yogeswara-reddy/iddq-cpu-fsm-testing/RWU_RV/RV_NoPipeline/spec/RWU_RV64I_Cache_Analysis.xlsx

Sheet: Legende
RWU-RV64I — Cache-Speichersystem (Hennessy-Patterson Analyse)
Prozess: X-Fab XO035 (350 nm) | Architektur: Harvard | Konfiguration: I-Cache + D-Cache (je 4-way SA, 4 KB), Scratchpad SRAM
Eigenschaft | I-Cache | D-Cache (Flash-Region) | D-Cache (Scratchpad-Region) | Scratchpad SRAM (Bypass)
Kapazität | 4 KB (param.) | 4 KB (param.) | n/a (bypass) | TBD (param.)
Assoziativität | 4-fach set-assoziativ | 4-fach set-assoziativ | — | direkt adressiert
Sets / Cacheline | 32 Sets, 32 B | 32 Sets, 32 B | — | —
Ersetzungsstrategie | Pseudo-LRU (3 Bit/Set) | Pseudo-LRU (3 Bit/Set) | — | —
Write Policy | read-only (kein Write) | read-allocate, no-write-back | kein Cache (bypass) | write-through direkt
Write-Allocate | nicht anwendbar | nein (Flash read-only) | nein (bypass) | nicht anwendbar
Dirty Bit | nein | nein (eliminiert) | nein | —
Hit-Latenz | 1 Systemtakt | 1 Systemtakt | 1–2 Systemtakte (bypass) | 1–2 Systemtakte
Miss-Penalty | 106 × f_sys/f_QSPI Takte | 106 × f_sys/f_QSPI Takte | — (kein Miss möglich) | —
AXI4 Write-Path | nein | nein (eliminiert) | nein | nein
AXI4 Read-Path | ja (AR + R Kanal) | ja (AR + R Kanal) | nein | nein
Bus zum Speicher | AXI4 Burst (ARLEN=3) | AXI4 Burst (ARLEN=3) | SRAM-Interface (sync.) | SRAM-Interface (sync.)
H&P Begriff |  | Bedeutung / Formel |  | In diesem System
Hit Time (t_hit) |  | Zugriffszeit bei Cache-Treffer |  | 1 Systemtakt (I+D)
Miss Rate (m) |  | Anteil Zugriffe ohne Treffer |  | I-Cache: abhängig vom Code-Footprint D-Cache (Flash): abhängig von .rodata-Zugriffen
Miss Penalty (t_miss) |  | Mehrzyklen bei Miss bis Daten bereit stehen |  | 106 × (f_sys / f_QSPI_SCK) Takte ≡ 4.24 µs bei 25 MHz QSPI (beide Flash-Typen)
AMAT |  | Average Memory Access Time = t_hit + m × t_miss |  | I: 1 + m_I × t_miss D: 1 + m_D × t_miss (nur Load-Misses aus Flash)
Memory Stall CPI |  | Taktzyklen/Instr. für Speicherwartezustände = m_I×t_miss + load_freq×m_D×t_miss |  | Store-Misses = 0 (Scratchpad-Bypass, kein Flash-Write)
CPI_eff |  | Effektiver CPI = CPI_ideal + Memory_Stall_CPI |  | CPI_ideal = 1 (No-Pipeline-CPU)
Write-Through |  | Jeder Write sofort in Backing Store |  | NICHT verwendet (kein Flash-Write)
Write-Back |  | Write erst bei Eviction in Backing Store |  | NICHT verwendet (Flash read-only, Dirty-Bit eliminiert)
Write-Allocate |  | Miss bei Write → Cache-Line laden |  | NICHT verwendet (Stores gehen direkt → Scratchpad)
No-Write-Allocate |  | Miss bei Write → direkt in Backing Store |  | NICHT relevant (Scratchpad ist nicht Flash)
Read-Allocate |  | Miss bei Load → neue Line in Cache laden |  | JA – für I-Cache und D-Cache (Flash-Region)
Pseudo-LRU (PLRU) |  | 3-Bit-Approximation des LRU für 4-Wege |  | 1 PLRU-Feld pro Set (96 Bit Tag-SRAM enthält 3 PLRU-Bits)
Scratchpad |  | Direkt adressierter SRAM (kein Cache) |  | Hält Stack, Heap, .data, .bss D-Cache-Controller bypassed direkt
Linker-Segment | Read/Write | Inhalt |  | Speicherort
.text | RO | Programmcode (Instruktionen) |  | NOR Flash → I-Cache
.rodata | RO | Konstanten, String-Literale |  | NOR Flash → D-Cache (Flash-Region)
.data | RW | Initialisierte globale/statische Variablen |  | Scratchpad (Kopie von Flash bei Boot)
.bss | RW | Uninitial. glob./stat. Var. (Null-Init.) |  | Scratchpad (Start-up nullt Region)
Heap | RW | Dynamisch alloz. Speicher (malloc/free) |  | Scratchpad (wächst ↑ von .bss)
Stack | RW | Auto-Variablen, Rücksprungadr., Register-Save |  | Scratchpad (wächst ↓ von oben)

Sheet: AMAT_Szenarien
AMAT-Analyse nach Hennessy-Patterson — RWU-RV64I Cache-System
System-Parameter
t_hit (I-Cache + D-Cache) |  | 1 | Systemtakt | Kombinatorisch: Tag-Vergleich + SRAM-Read in 1 Takt
t_hit (Scratchpad Bypass) |  | 1–2 | Systemtakte | D-Cache-Controller → SRAM direkt
QSPI-Protokoll-Zyklen (tot.) |  | 106 | QSPI-SCK-Takte | 8 (Opcode)+24 (Adr)+8 (Dummy)+64 (Daten, Quad)+2 (CS#)
Miss-Penalty t_miss |  | 106 × (f_sys / f_QSPI) | Systemtakte | Skalar von Taktverhältnis, siehe Takt-Matrix
Beispiel: f_sys=25 MHz, f_QSPI=25 MHz |  | 106 | Systemtakte | ≡ 4.24 µs
Beispiel: f_sys=10 MHz, f_QSPI=25 MHz |  | 42 | Systemtakte | ≡ 4.24 µs (Spec-Referenzpunkt)
CPI_ideal (No-Pipeline) |  | 1 | Takte/Instr. | Ein Fetch pro Takt (ohne Speicherstalls)
Instruction Mix (typisch) |  | — | — | 25 % Load, 10 % Store, 20 % Branch, 45 % ALU
Store-Miss-Penalty |  | 0 | — | Stores → Scratchpad Bypass (kein Flash-Write)
Hennessy-Patterson Formeln (angewendet auf RWU-RV64I)
AMAT = t_hit + m × t_miss
CPI_eff = CPI_ideal + I$_stall + D$_stall
I$_stall = m_I × t_miss [Takte pro Instruktion]
D$_stall = load_freq × m_D × t_miss [Store-Miss = 0, Scratchpad-Bypass!]
Memory_Stall_CPI = m_I × t_miss + 0.25 × m_D × t_miss
Szenario: f_sys=10 MHz, f_QSPI=25 MHz (Spec-Referenz) | t_miss = 42 Systemtakte
Miss-Rate m | AMAT_I [Takte] | AMAT_D [Takte] | I$_stall/Instr | D$_stall/Instr | Mem_Stall_CPI | CPI_eff | IPC_eff | Speed-Up vs. ideal | Zeitverlust [%] | CPI-Diagramm (normiert) | Klassifikation
0.1 % | 1.04 | 1.04 | 0.04 | 0.01 | 0.05 | 1.05 | 0.950 | 1.05 | 5.2 | █ | sehr gut
0.5 % | 1.21 | 1.21 | 0.21 | 0.05 | 0.26 | 1.26 | 0.792 | 1.26 | 26.2 | █ | sehr gut
1.0 % | 1.42 | 1.42 | 0.42 | 0.10 | 0.53 | 1.52 | 0.656 | 1.52 | 52.5 | █ | sehr gut
2.0 % | 1.84 | 1.84 | 0.84 | 0.21 | 1.05 | 2.05 | 0.488 | 2.05 | 105.0 | █ | gut
5.0 % | 3.10 | 3.10 | 2.10 | 0.53 | 2.62 | 3.62 | 0.276 | 3.62 | 262.5 | ██ | gut
10.0 % | 5.20 | 5.20 | 4.20 | 1.05 | 5.25 | 6.25 | 0.160 | 6.25 | 525.0 | █████ | akzeptabel
15.0 % | 7.30 | 7.30 | 6.30 | 1.57 | 7.88 | 8.88 | 0.113 | 8.88 | 787.5 | ███████ | problematisch
20.0 % | 9.40 | 9.40 | 8.40 | 2.10 | 10.50 | 11.50 | 0.087 | 11.50 | 1050.0 | ██████████ | problematisch
30.0 % | 13.60 | 13.60 | 12.60 | 3.15 | 15.75 | 16.75 | 0.060 | 16.75 | 1575.0 | ███████████████ | kritisch
50.0 % | 22.00 | 22.00 | 21.00 | 5.25 | 26.25 | 27.25 | 0.037 | 27.25 | 2625.0 | ████████████████████+ | kritisch
Grün ≤ 1 % | Hell-Grün ≤ 5 % | Gelb ≤ 10 % | Orange ≤ 20 % | Rot > 20 %
Szenario: f_sys=25 MHz, f_QSPI=25 MHz (Empfehlung: kein PLL) | t_miss = 106 Systemtakte
Miss-Rate m | AMAT_I [Takte] | AMAT_D [Takte] | I$_stall/Instr | D$_stall/Instr | Mem_Stall_CPI | CPI_eff | IPC_eff | Speed-Up vs. ideal | Zeitverlust [%] | CPI-Diagramm (normiert) | Klassifikation
0.1 % | 1.11 | 1.11 | 0.11 | 0.03 | 0.13 | 1.13 | 0.883 | 1.13 | 13.3 | █ | sehr gut
0.5 % | 1.53 | 1.53 | 0.53 | 0.13 | 0.66 | 1.66 | 0.602 | 1.66 | 66.3 | █ | sehr gut
1.0 % | 2.06 | 2.06 | 1.06 | 0.27 | 1.32 | 2.33 | 0.430 | 2.33 | 132.5 | █ | sehr gut
2.0 % | 3.12 | 3.12 | 2.12 | 0.53 | 2.65 | 3.65 | 0.274 | 3.65 | 265.0 | ██ | gut
5.0 % | 6.30 | 6.30 | 5.30 | 1.32 | 6.63 | 7.63 | 0.131 | 7.63 | 662.5 | ██████ | gut
10.0 % | 11.60 | 11.60 | 10.60 | 2.65 | 13.25 | 14.25 | 0.070 | 14.25 | 1325.0 | █████████████ | akzeptabel
15.0 % | 16.90 | 16.90 | 15.90 | 3.98 | 19.88 | 20.88 | 0.048 | 20.88 | 1987.5 | ███████████████████ | problematisch
20.0 % | 22.20 | 22.20 | 21.20 | 5.30 | 26.50 | 27.50 | 0.036 | 27.50 | 2650.0 | ████████████████████+ | problematisch
30.0 % | 32.80 | 32.80 | 31.80 | 7.95 | 39.75 | 40.75 | 0.025 | 40.75 | 3975.0 | ████████████████████+ | kritisch
50.0 % | 54.00 | 54.00 | 53.00 | 13.25 | 66.25 | 67.25 | 0.015 | 67.25 | 6625.0 | ████████████████████+ | kritisch
Grün ≤ 1 % | Hell-Grün ≤ 5 % | Gelb ≤ 10 % | Orange ≤ 20 % | Rot > 20 %
Szenario: f_sys=50 MHz, f_QSPI=25 MHz (Empfehlung: PLL×2) | t_miss = 212 Systemtakte
Miss-Rate m | AMAT_I [Takte] | AMAT_D [Takte] | I$_stall/Instr | D$_stall/Instr | Mem_Stall_CPI | CPI_eff | IPC_eff | Speed-Up vs. ideal | Zeitverlust [%] | CPI-Diagramm (normiert) | Klassifikation
0.1 % | 1.21 | 1.21 | 0.21 | 0.05 | 0.27 | 1.26 | 0.791 | 1.26 | 26.5 | █ | sehr gut
0.5 % | 2.06 | 2.06 | 1.06 | 0.27 | 1.32 | 2.33 | 0.430 | 2.33 | 132.5 | █ | sehr gut
1.0 % | 3.12 | 3.12 | 2.12 | 0.53 | 2.65 | 3.65 | 0.274 | 3.65 | 265.0 | ██ | sehr gut
2.0 % | 5.24 | 5.24 | 4.24 | 1.06 | 5.30 | 6.30 | 0.159 | 6.30 | 530.0 | █████ | gut
5.0 % | 11.60 | 11.60 | 10.60 | 2.65 | 13.25 | 14.25 | 0.070 | 14.25 | 1325.0 | █████████████ | gut
10.0 % | 22.20 | 22.20 | 21.20 | 5.30 | 26.50 | 27.50 | 0.036 | 27.50 | 2650.0 | ████████████████████+ | akzeptabel
15.0 % | 32.80 | 32.80 | 31.80 | 7.95 | 39.75 | 40.75 | 0.025 | 40.75 | 3975.0 | ████████████████████+ | problematisch
20.0 % | 43.40 | 43.40 | 42.40 | 10.60 | 53.00 | 54.00 | 0.019 | 54.00 | 5300.0 | ████████████████████+ | problematisch
30.0 % | 64.60 | 64.60 | 63.60 | 15.90 | 79.50 | 80.50 | 0.012 | 80.50 | 7950.0 | ████████████████████+ | kritisch
50.0 % | 107.00 | 107.00 | 106.00 | 26.50 | 132.50 | 133.50 | 0.007 | 133.50 | 13250.0 | ████████████████████+ | kritisch
Grün ≤ 1 % | Hell-Grün ≤ 5 % | Gelb ≤ 10 % | Orange ≤ 20 % | Rot > 20 %
Szenario: f_sys=50 MHz, f_QSPI=50 MHz (aggressiv, div=1) | t_miss = 106 Systemtakte
Miss-Rate m | AMAT_I [Takte] | AMAT_D [Takte] | I$_stall/Instr | D$_stall/Instr | Mem_Stall_CPI | CPI_eff | IPC_eff | Speed-Up vs. ideal | Zeitverlust [%] | CPI-Diagramm (normiert) | Klassifikation
0.1 % | 1.11 | 1.11 | 0.11 | 0.03 | 0.13 | 1.13 | 0.883 | 1.13 | 13.3 | █ | sehr gut
0.5 % | 1.53 | 1.53 | 0.53 | 0.13 | 0.66 | 1.66 | 0.602 | 1.66 | 66.3 | █ | sehr gut
1.0 % | 2.06 | 2.06 | 1.06 | 0.27 | 1.32 | 2.33 | 0.430 | 2.33 | 132.5 | █ | sehr gut
2.0 % | 3.12 | 3.12 | 2.12 | 0.53 | 2.65 | 3.65 | 0.274 | 3.65 | 265.0 | ██ | gut
5.0 % | 6.30 | 6.30 | 5.30 | 1.32 | 6.63 | 7.63 | 0.131 | 7.63 | 662.5 | ██████ | gut
10.0 % | 11.60 | 11.60 | 10.60 | 2.65 | 13.25 | 14.25 | 0.070 | 14.25 | 1325.0 | █████████████ | akzeptabel
15.0 % | 16.90 | 16.90 | 15.90 | 3.98 | 19.88 | 20.88 | 0.048 | 20.88 | 1987.5 | ███████████████████ | problematisch
20.0 % | 22.20 | 22.20 | 21.20 | 5.30 | 26.50 | 27.50 | 0.036 | 27.50 | 2650.0 | ████████████████████+ | problematisch
30.0 % | 32.80 | 32.80 | 31.80 | 7.95 | 39.75 | 40.75 | 0.025 | 40.75 | 3975.0 | ████████████████████+ | kritisch
50.0 % | 54.00 | 54.00 | 53.00 | 13.25 | 66.25 | 67.25 | 0.015 | 67.25 | 6625.0 | ████████████████████+ | kritisch
Grün ≤ 1 % | Hell-Grün ≤ 5 % | Gelb ≤ 10 % | Orange ≤ 20 % | Rot > 20 %

Sheet: Takt_Matrix
Takt-Kombinations-Matrix — RWU-RV64I (QSPI / CPU-Core / SoC / Eingangs-Takt)
Referenz-Flash-Geräte
Gerät | Kapazität | Max SCK (Datenblatt) | Max SCK (Design-Ziel) | Quad-Read Opcode | Dummy-Zyklen | JEDEC-ID |  | Anmerkung
Gerät | Kapazität | Max SCK (Datenblatt) | Max SCK (Design-Ziel) | Quad-Read Opcode | Dummy-Zyklen | JEDEC-ID | Anmerkung
Winbond W25Q128JV | 128 Mbit (16 MB) | 133 MHz | 80 MHz (konservativ, 2.7–3.6 V) | 0x6B (Quad Out, 1-1-4) | 8 | 0xEF | ★ Primär-Referenz laut Spec
Micron MT25QL128 | 128 Mbit (16 MB) | 133 MHz | 80 MHz (konservativ, 2.7–3.6 V) | 0x6B (Quad Out, 1-1-4) | 8 | 0x20 | ★ Sekundär-Referenz laut Spec
# | Quarz f_in [MHz] | PLL (ja/nein) | PLL-Faktor N | f_sys / f_CPU [MHz] | QSPI-Takt Quelle | QSPI-Divider (÷) | f_QSPI_SCK [MHz] | t_QSPI-Takt [ns] | QSPI-Zyklen (Protokoll) | t_miss [µs] | Miss-Penalty [Systemtakte] | W25Q128JV (≤80 MHz?) | MT25QL128 (≤80 MHz?) | AMAT @ 1 % Miss | AMAT @ 5 % Miss | AMAT @ 10 % Miss | AMAT @ 20 % Miss | Timing-Risiko MISO-Setup | Empfehlung
1 | 10 | ja | 5 | 50 | f_sys / Div. | 1 | 50 | 20.0 | 106 | 2.12 | 106 | ✓ | ✓ | 2.1 | 6.3 | 11.6 | 22.2 | moderat | ★★ BESTE OPTION f_sys=50 MHz, SCK=50.0 MHz, t_miss=106 Takte
2 | 25 | ja | 2 | 50 | f_sys / Div. | 1 | 50 | 20.0 | 106 | 2.12 | 106 | ✓ | ✓ | 2.1 | 6.3 | 11.6 | 22.2 | moderat | ★★ BESTE OPTION f_sys=50 MHz, SCK=50.0 MHz, t_miss=106 Takte
3 | 10 | ja | 5 | 50 | f_sys / Div. | 2 | 25 | 40.0 | 106 | 4.24 | 212 | ✓ | ✓ | 3.1 | 11.6 | 22.2 | 43.4 | gering | ★★ EMPFOHLEN f_sys=50 MHz, f_QSPI=25.0 MHz, Timing sicher
4 | 25 | ja | 2 | 50 | f_sys / Div. | 2 | 25 | 40.0 | 106 | 4.24 | 212 | ✓ | ✓ | 3.1 | 11.6 | 22.2 | 43.4 | gering | ★★ EMPFOHLEN f_sys=50 MHz, f_QSPI=25.0 MHz, Timing sicher
5 | 25 | ja | 2 | 50 | f_in (direkt) | 1 | 25 | 40.0 | 106 | 4.24 | 212 | ✓ | ✓ | 3.1 | 11.6 | 22.2 | 43.4 | gering (async. Taktdomäne) | ★★ EMPFOHLEN f_sys=50 MHz, f_QSPI=25 MHz, Timing sicher
6 | 10 | ja | 5 | 50 | f_sys / Div. | 4 | 12.5 | 80.0 | 106 | 8.48 | 424 | ✓ | ✓ | 5.2 | 22.2 | 43.4 | 85.8 | gering
7 | 25 | ja | 2 | 50 | f_sys / Div. | 4 | 12.5 | 80.0 | 106 | 8.48 | 424 | ✓ | ✓ | 5.2 | 22.2 | 43.4 | 85.8 | gering
8 | 10 | ja | 5 | 50 | f_in (direkt) | 1 | 10 | 100.0 | 106 | 10.60 | 530 | ✓ | ✓ | 6.3 | 27.5 | 54.0 | 107.0 | gering (async. Taktdomäne)
9 | 10 | ja | 4 | 40 | f_sys / Div. | 1 | 40 | 25.0 | 106 | 2.65 | 106 | ✓ | ✓ | 2.1 | 6.3 | 11.6 | 22.2 | gering | ★ GUT PLL×4, f_sys=40 MHz, f_QSPI=40.0 MHz
10 | 20 | ja | 2 | 40 | f_sys / Div. | 1 | 40 | 25.0 | 106 | 2.65 | 106 | ✓ | ✓ | 2.1 | 6.3 | 11.6 | 22.2 | gering | ★ GUT PLL×2, f_sys=40 MHz, f_QSPI=40.0 MHz
11 | 10 | ja | 4 | 40 | f_sys / Div. | 2 | 20 | 50.0 | 106 | 5.30 | 212 | ✓ | ✓ | 3.1 | 11.6 | 22.2 | 43.4 | gering
12 | 20 | ja | 2 | 40 | f_sys / Div. | 2 | 20 | 50.0 | 106 | 5.30 | 212 | ✓ | ✓ | 3.1 | 11.6 | 22.2 | 43.4 | gering
13 | 10 | ja | 4 | 40 | f_sys / Div. | 4 | 10 | 100.0 | 106 | 10.60 | 424 | ✓ | ✓ | 5.2 | 22.2 | 43.4 | 85.8 | gering
14 | 20 | ja | 2 | 40 | f_sys / Div. | 4 | 10 | 100.0 | 106 | 10.60 | 424 | ✓ | ✓ | 5.2 | 22.2 | 43.4 | 85.8 | gering
15 | 25 | nein | — | 25 | f_sys / Div. | 1 | 25 | 40.0 | 106 | 4.24 | 106 | ✓ | ✓ | 2.1 | 6.3 | 11.6 | 22.2 | gering | ★ GUT kein PLL, f_sys=25 MHz, f_QSPI=25.0 MHz
16 | 25 | nein | — | 25 | f_sys / Div. | 2 | 12.5 | 80.0 | 106 | 8.48 | 212 | ✓ | ✓ | 3.1 | 11.6 | 22.2 | 43.4 | gering
17 | 25 | nein | — | 25 | f_sys / Div. | 4 | 6.25 | 160.0 | 106 | 16.96 | 424 | ✓ | ✓ | 5.2 | 22.2 | 43.4 | 85.8 | gering
18 | 10 | ja | 2 | 20 | f_sys / Div. | 1 | 20 | 50.0 | 106 | 5.30 | 106 | ✓ | ✓ | 2.1 | 6.3 | 11.6 | 22.2 | gering
19 | 20 | nein | — | 20 | f_sys / Div. | 1 | 20 | 50.0 | 106 | 5.30 | 106 | ✓ | ✓ | 2.1 | 6.3 | 11.6 | 22.2 | gering
20 | 10 | ja | 2 | 20 | f_sys / Div. | 2 | 10 | 100.0 | 106 | 10.60 | 212 | ✓ | ✓ | 3.1 | 11.6 | 22.2 | 43.4 | gering
21 | 20 | nein | — | 20 | f_sys / Div. | 2 | 10 | 100.0 | 106 | 10.60 | 212 | ✓ | ✓ | 3.1 | 11.6 | 22.2 | 43.4 | gering
22 | 10 | ja | 2 | 20 | f_in (direkt) | 1 | 10 | 100.0 | 106 | 10.60 | 212 | ✓ | ✓ | 3.1 | 11.6 | 22.2 | 43.4 | gering (async. Taktdomäne)
23 | 10 | ja | 2 | 20 | f_sys / Div. | 4 | 5 | 200.0 | 106 | 21.20 | 424 | ✓ | ✓ | 5.2 | 22.2 | 43.4 | 85.8 | gering
24 | 20 | nein | — | 20 | f_sys / Div. | 4 | 5 | 200.0 | 106 | 21.20 | 424 | ✓ | ✓ | 5.2 | 22.2 | 43.4 | 85.8 | gering
25 | 10 | nein | — | 10 | f_sys / Div. | 1 | 10 | 100.0 | 106 | 10.60 | 106 | ✓ | ✓ | 2.1 | 6.3 | 11.6 | 22.2 | gering
26 | 10 | nein | — | 10 | f_sys / Div. | 2 | 5 | 200.0 | 106 | 21.20 | 212 | ✓ | ✓ | 3.1 | 11.6 | 22.2 | 43.4 | gering
27 | 10 | nein | — | 10 | f_sys / Div. | 4 | 2.5 | 400.0 | 106 | 42.40 | 424 | ✓ | ✓ | 5.2 | 22.2 | 43.4 | 85.8 | gering
Farb-Legende
★★ BESTE OPTION / EMPFOHLEN – optimales Verhältnis aus Performance und Timing-Sicherheit
★ GUT – geeignet für Referenzdesign
◎ akzeptabel – funktioniert, aber suboptimale Miss-Penalty oder Performance
Erhöhtes Timing-Risiko – MISO-Setup muss im Place&Route verifiziert werden
Nicht empfohlen – außerhalb Flash-Spec oder kritisches Timing
