yogeswara-reddy/iddq-cpu-fsm-testing/RWU_RV/RV_NoPipeline/RV_NoPipeline.srcs/constrs_1/new/iddq_cpu_fsm_fault_top.xdc

## ============================================================
## iddq_cpu_fsm_fault_top.xdc  (Zybo Z7-10, xc7z010clg400-1)
##
## Fixes vs original:
##   - fault_sel_i widened to 3 bits; fault_sel_i[2] added on BTN1
##   - removed D18 double-assignment (execld_o + fault_active_o);
##     fault_active_o moved to PMOD JA[2]
## ============================================================

## Clock - 125 MHz
set_property PACKAGE_PIN L16 [get_ports clk_i]
set_property IOSTANDARD LVCMOS33 [get_ports clk_i]
create_clock -period 8.000 -name sys_clk [get_ports clk_i]

## Reset - BTN0
set_property PACKAGE_PIN R18 [get_ports rst_i]
set_property IOSTANDARD LVCMOS33 [get_ports rst_i]

## SW0 - load_pending
set_property PACKAGE_PIN G15 [get_ports load_pending_i]
set_property IOSTANDARD LVCMOS33 [get_ports load_pending_i]

## SW1 - iddq_measure
set_property PACKAGE_PIN P15 [get_ports iddq_measure_i]
set_property IOSTANDARD LVCMOS33 [get_ports iddq_measure_i]

## SW2 - fault_sel[0]
set_property PACKAGE_PIN W13 [get_ports {fault_sel_i[0]}]
set_property IOSTANDARD LVCMOS33 [get_ports {fault_sel_i[0]}]

## SW3 - fault_sel[1]
set_property PACKAGE_PIN T16 [get_ports {fault_sel_i[1]}]
set_property IOSTANDARD LVCMOS33 [get_ports {fault_sel_i[1]}]

## BTN1 - fault_sel[2]  (verify against your Zybo-Master.xdc)
set_property PACKAGE_PIN P16 [get_ports {fault_sel_i[2]}]
set_property IOSTANDARD LVCMOS33 [get_ports {fault_sel_i[2]}]

## LED0 - fetch0
set_property PACKAGE_PIN M14 [get_ports fetch0_o]
set_property IOSTANDARD LVCMOS33 [get_ports fetch0_o]

## LED1 - fetch1
set_property PACKAGE_PIN M15 [get_ports fetch1_o]
set_property IOSTANDARD LVCMOS33 [get_ports fetch1_o]

## LED2 - exec
set_property PACKAGE_PIN G14 [get_ports exec_o]
set_property IOSTANDARD LVCMOS33 [get_ports exec_o]

## LED3 - execld
set_property PACKAGE_PIN D18 [get_ports execld_o]
set_property IOSTANDARD LVCMOS33 [get_ports execld_o]

## PMOD JA[0] - state bit 0
set_property PACKAGE_PIN N15 [get_ports {state_obs_o[0]}]
set_property IOSTANDARD LVCMOS33 [get_ports {state_obs_o[0]}]

## PMOD JA[1] - state bit 1
set_property PACKAGE_PIN L14 [get_ports {state_obs_o[1]}]
set_property IOSTANDARD LVCMOS33 [get_ports {state_obs_o[1]}]

## PMOD JA[2] - fault_active  (moved here to resolve D18 conflict)
set_property PACKAGE_PIN K16 [get_ports fault_active_o]
set_property IOSTANDARD LVCMOS33 [get_ports fault_active_o]

## False paths on static control signals
set_false_path -from [get_ports iddq_measure_i]
set_false_path -from [get_ports {fault_sel_i[*]}]

## ============================================================
## Basic I/O timing constraints
## These remove TIMING-18 methodology warnings by defining
## external input/output timing relative to sys_clk.
## ============================================================

## rst_i is asynchronous reset, so exclude it from synchronous timing
set_false_path -from [get_ports rst_i]

## load_pending_i is treated as an external synchronous input
##set_input_delay 2.000 -clock sys_clk [get_ports load_pending_i]

## Output delays for observable FSM outputs
##set_output_delay 2.000 -clock sys_clk [get_ports fetch0_o]
##set_output_delay 2.000 -clock sys_clk [get_ports fetch1_o]
##set_output_delay 2.000 -clock sys_clk [get_ports exec_o]
##set_output_delay 2.000 -clock sys_clk [get_ports execld_o]
##set_output_delay 2.000 -clock sys_clk [get_ports {state_obs_o[*]}]
##set_output_delay 2.000 -clock sys_clk [get_ports fault_active_o]
