yogeswara-reddy/iddq-cpu-fsm-testing/(commit log)

2026-05-09 Refactor CMake: simulator selection, fix source-tree pollution, add Verilator
    - Add -DSIMULATOR=xsim|verilator and -DWAVES=ON to root CMake
    - Fix: ASM_FILE and TB_FILE passed directly to sub-CMakes instead of copying
    files into the source tree (parallel-build safe)
    - sim/CMakeLists.txt: xsim and Verilator backends, each with simulate + waves
    - Verilator: --binary mode, --trace-fst, GTKWave for waves target
    - collect_errors.cmake: remove redundant string(REPLACE), clean debug output
    - Backup originals as *_orig; add sim/CMakeLists.txt exception to .gitignore
2026-05-10 Add Verilator FST waveform support via custom sim_main.cpp
    - Switch from --binary to --cc --exe --build with sim_main.cpp
    - sim_main.cpp enables VerilatedFstC tracing and writes dump.fst
    without requiring $dumpfile/$dumpvars in the SystemVerilog testbenches
    - Add --timing flag for proper SV initial-block delay handling
    - GTKWave opens dump.fst when -DWAVES=ON is set
2026-05-12 Add MEM-07: QSPI cache-miss-driven burst mode (indirect XIP)
    - True XIP (Continuous Read) rejected: I-Cache provides the XIP benefit,
    random-address refills gain little, simpler controller without mode bits
    - Cache-miss-driven burst: fresh Quad Fast Read (0x6B) per cache miss
    - Address mapping: ARADDR[24:5] directly to Flash address; bits[4:0]=0
    - Latency estimate: 106 QSPI clocks (8 opcode + 24 addr + 8 dummy +
    64 data) ≈ 42 system clocks at 25 MHz QSPI / 10 MHz system clock
    - NOR Flash requirements documented (0x6B support, 3.3V, 3-byte addr)
    - All MEM-01..MEM-07 items now resolved or in-progress (MEM-02 pending
    compiler run)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
2026-05-12 Rewrite bus concept: dual-bus architecture (Wishbone + AXI4)
    Documents the final dual-bus decision: Wishbone B4 Classic for all
    peripherals (GPIO, UART, QSPI config), AXI4 read-only subset (AR+R,
    ARLEN=3, 64-bit, INCR burst) exclusively for Cache↔Arbiter↔QSPI data
    path. Adds topology block diagram, bus selection rationale, AXI4
    parameter table, and Wishbone vs. AXI4 comparison table.
2026-05-12 Fix asQspiTop: embed register constants as localparam for Vivado compatibility
    Replace all as_pack qspi_*_c references with local OFF_* / RST_* localparams
    inside the module body. Vivado resolves as_pack from the RWU_RV tree where the
    QSPI constants are commented out, causing 20+ 'not declared' errors at simulation
    launch. The local constants make the module portable across both as_pack variants.
    [asQspiTop.sv]
2026-05-12 Fix axi_burst_read task: resolve AR-handshake deadlock and last-beat RREADY timing
    Two bugs in axi_burst_read caused T13 to hit the watchdog:
    1. Deadlock: ARREADY was sampled at posedge+#1 (after NBA), at which point the
    DUT had already captured the handshake and moved to AXI_KICK, dropping
    arready to 0. The while loop then spun forever waiting for arready=1, which
    requires AXI_RESP→AXI_IDLE, which requires rready=1 — set only after the loop.
    Fix: sample arready at negedge (combinatorial, before the sampling posedge).
    2. FSM stuck in AXI_RESP: rready was deasserted at the negedge right after
    reading beat3, before the DUT had a posedge to execute the beat_cnt=3
    handsh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
    [asQspiTop_tb.sv]
2026-05-13 Add SV module architecture section and cache analysis Excel to memory spec
    spec/03_arch/03_arch_memory_concept.tex:
    - New subsection "SystemVerilog Module Architecture" describing all 8
    modules: asMemTop, asICacheCtrl, asDCacheCtrl, asICacheBlock,
    asDCacheBlock, asSpBlock, asMemArb, asSpramModel.
    - Each module documented with full port table (signal, direction, width,
    connected-to, description) and internal algorithm.
    - Includes asSpramModel simulation guard (`ifdef SIMULATION) and
    write-first SPRAM behavioural model.
    spec/RWU_RV64I_Cache_Analysis.xlsx + gen_cache_analysis.py:
    - Excel workbook with H&P AMAT scenarios, clock-frequency matrix, and
    recommended clock combinations for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
    [RWU_RV64I_Cache_Analysis.xlsx]
2026-05-13 Add ip_memarb: AXI4 Memory Arbiter with Verilator testbench
    - as_pack.sv: add as_icache_if, as_dcache_if, as_axi4_if interfaces
    (defined outside the package block, as required by SV)
    - ip_memarb/src/asMemArb.sv: fixed-priority arbiter (D-Cache > I-Cache),
    read-only AXI4 path to QSPI; write channels tied off
    - ip_memarb/tb/tb_asMemArb.sv: 6 test cases, 23 checks; BFM tasks sample
    arready/rvalid at posedge to avoid posedge+#1 race with qspi_serve
    - ip_memarb/sim/sim_main.cpp: Verilator C++ driver with FST trace
    - ip_memarb/CMakeLists.txt: self-contained build with verilate/simulate/waves
    [asMemArb.sv, as_pack.sv, tb_asMemArb.sv]
2026-05-13 Add ip_icache: 4-way SA instruction cache with Verilator testbench
    DUT: asICache.sv – SETS=32, WAYS=4, LINE=32 B, AXI4 64-bit master,
    PLRU victim selection, FLUSH support, behavioral SRAM models.
    TB: tb_asICache.sv – TC01–TC07 (27 checks): cold miss, hit,
    offset hit, multi-set miss, 4-way fill, flush+re-miss, AXI4 error.
    Key implementation detail: rdata_r is computed in the FILL state
    (when rlast arrives) so it is a stable registered value by the time
    RESPOND asserts rvalid_r, avoiding Verilator NBA read-ordering issues.
    TB uses a one-cycle ic_req pulse to prevent spurious re-requests.
    [tb_asICache.sv]
2026-05-14 Add ip_scratch: synchronous scratchpad SRAM with Verilator testbench
    64-bit × 1024 synchronous SRAM with byte-enable writes and RISC-V
    dc_size sign/zero extension on reads. Reuses as_dcache_if interface.
    1-cycle read stall, no AXI4. TC01–TC12, 20 checks, all passing.
    [tb_asScratch.sv]
2026-05-20 Add D-Cache comprehensive test (dcache_test)
    RISC-V assembler test (dcache_test.asm) and SystemVerilog testbench
    (tb_rv64i_dcache_test.sv) covering: cold miss/line fill, intra-line hits,
    lb/lbu/lh/lhu/lw/lwu sub-word extraction, 4-way PLRU eviction (set0 W0
    evicted on 5th tag), post-eviction reload, and independent-set isolation.
    Testbench asserts PLRU tree state and valid bits at checkpoints 0x03/0x04.
    Also adds dcache_test to the RV_NoPipelineCache regression test list.
